Wren6991/Multimeter/pcb/case02.jpg

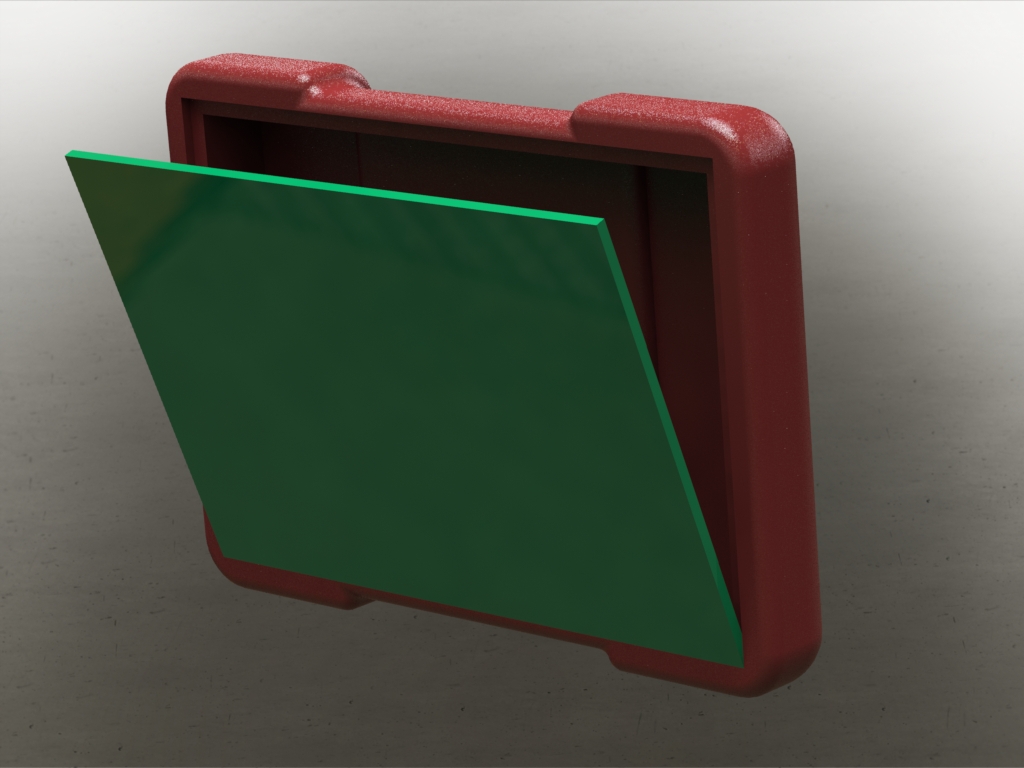
pcb/case02.jpg
