Wren6991/Multimeter/pcb/case01.JPG

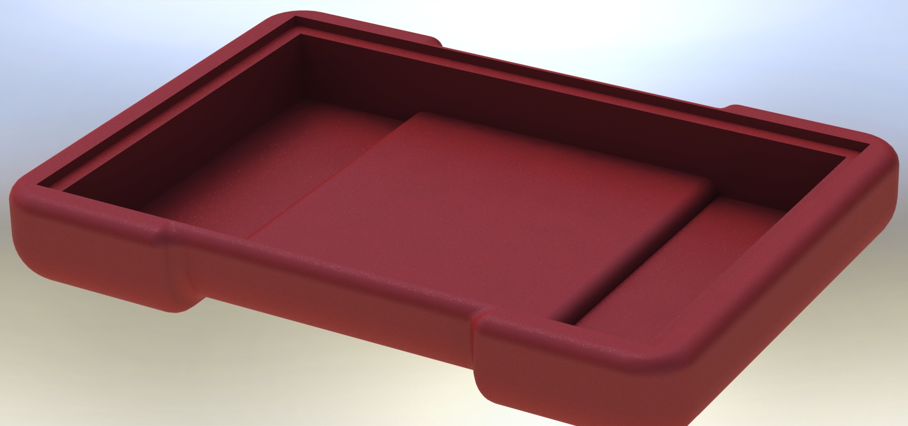
pcb/case01.JPG
