Wren6991/Multimeter/pcb/BOM.xlsx

Part no. | Description | Unit Cost (£ ex VAT) | Count | Total Cost
ATmega324PA | Microcontroller | 3.2 | 1
 | Lithium battery charger | 1 | 1
 | Infrared LED |  | 1
 | Yellow indicator LED |  | 1
 | Resistor 1206 0.22 Ohm |  | 1
 | Resistor 0805 47 Ohm |  | 2
 | Resistor 0805 500 Ohm |  | 3
 | Resistor 0805 1 kOhm |  | 9
 | Resistor 0805 5 kOhm |  | 3
 | Resistor 0805 10 kOhm |  | 2
 | Resistor 0805 20 kOhm |  | 1
 | Resistor 0805 100 kOhm |  | 1
 | Resistor 0805 1 MOhm |  | 2
 | Resistor Axial 0.25W 1MOhm |  | 1
 | MOSFET Logic N |  | 3
 | MOSFET Power N |  | 1
M25P16VP | SPI Flash 16Mbit |  | 1
MCP6502 | Opamp dual rail->rail low power |  | 1
 | 4mm Binding Post Black |  | 1
 | 4mm Binding Post Red |  | 2
 | Crystal 8MHz |  | 1
 | Capacitor 0805 0.1uF |  | 8
 | Capacitor 0603 22pF |  | 2
 | Diode Schottky 500mA |  | 4
 | Fuse 1206 2A fastblow |  | 1
 | Infrared Receiver 38kHz |  | 1
 | Switch Momentary Tactile |  | 4
