Wren6991/Multimeter/pcb/multimeter.brd

## EAGLE design pcb/multimeter.brd (2014-09-06)

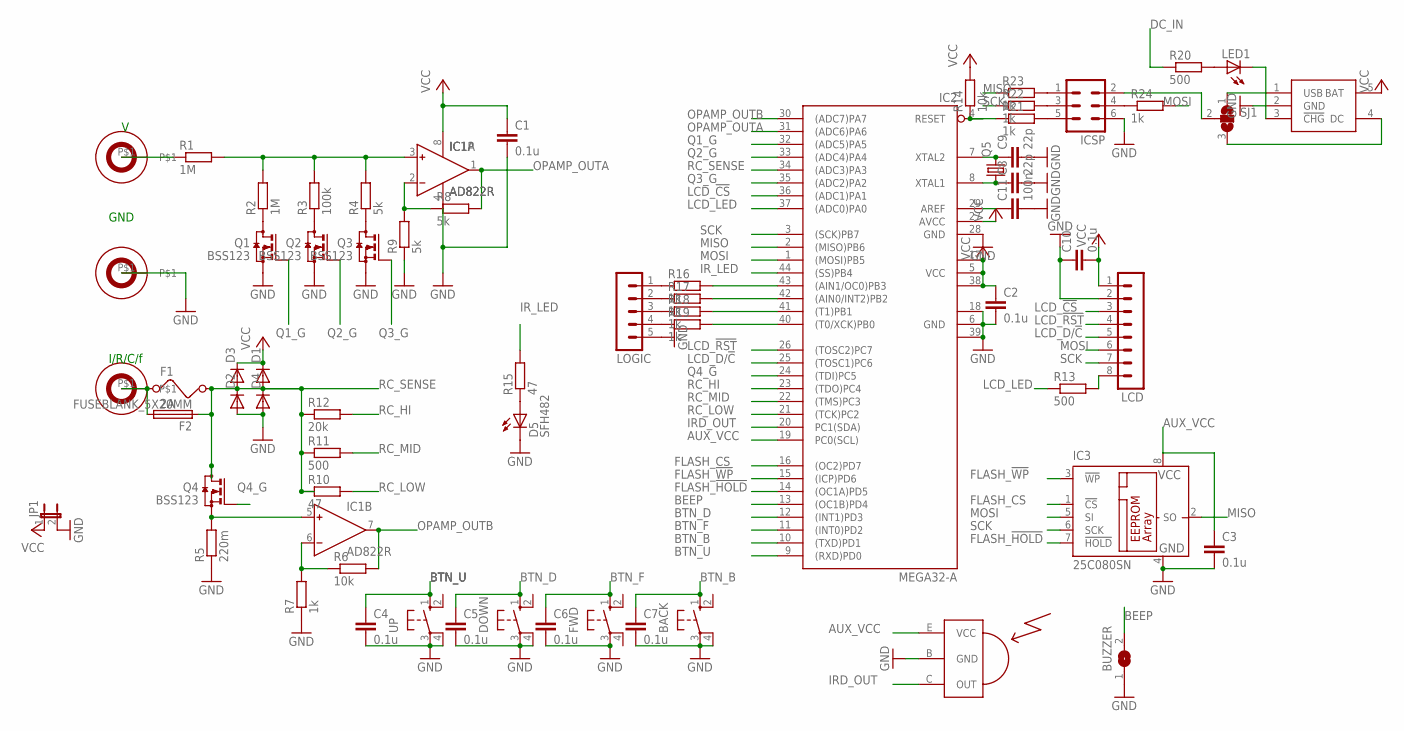
[picture p3: schematic multimeter.sch]

Parts:
BACK: 10-XX; B3F-10XX
BUZZER: SJW
C1, C2, C3, C4, C5, C6, C7, C10: 0.1u; C0805
C8, C9: 22p; C0603
C11: 100n; C0805
D1, D2, D3, D4: DIODE-SOD123; SOD123
D5: SFH482
DOWN: 10-XX; B3F-10XX
F1: 2A; R1206
F2: FUSEBLANK_5X20MM; FUSE_HOLDER_5X20MM
FWD: 10-XX; B3F-10XX
IC1: AD822R; SO8
IC2: MEGA32-A; TQFP44
IC3: 25C080SN; SO-08
ICSP: MA03-2
JP1: JP1E; JP1
LCD: MA08-1
LED1: LEDSML0805; SML0805
LOGIC: MA05-1
N$36: BINDINGPOST4MMPCB; BINDINGPOSTPCB
Q1, Q2, Q3, Q4: BSS123; SOT23
Q5: CRYSTALHC49UP; HC49UP
R1: 1M; 0207/12
R2: 1M; R0805
R3: 100k; R0805
R4, R8, R9: 5k; R0805
R5: 220m; R1206
R6, R14: 10k; R0805
R7, R16, R17, R18, R19, R21, R22, R23, R24: 1k; R0805
R10, R15: 47; R0805
R11, R13, R20: 500; R0805
R12: 20k; R0805
SJ1: SJ2W; SJ_2
U$1, U$2: BINDINGPOST4MMPCB; BINDINGPOSTPCB
U$3: IRDETECTOR; TO92-EBC
U$4: LITHIUMCHARGER; SOT23-5L
UP: 10-XX; B3F-10XX

Connections:
AUX_VCC: C3.1, IC2.19 (PC0(SCL)), IC3.8 (VCC), U$3.E (VCC)
BEEP: BUZZER.2, IC2.13 ((OC1B)PD4)
BTN_B: BACK.1 (S), C7.1, IC2.10 ((TXD)PD1)
BTN_D: C5.1, DOWN.1 (S), IC2.12 ((INT1)PD3)
BTN_F: C6.1, FWD.1 (S), IC2.11 ((INT0)PD2)
BTN_U: C4.1, IC2.9 ((RXD)PD0), UP.1 (S)
DC_IN: ICSP.2, R20.1, SJ1.2
FLASH_!HOLD: IC2.14 ((OC1A)PD5), IC3.7 (!HOLD)
FLASH_!WP: IC2.15 ((ICP)PD6), IC3.3 (!WP)
FLASH_CS: IC2.16 ((OC2)PD7), IC3.1 (!CS)
GND: BACK.3, BACK.4 (P1), BUZZER.1, C1.2, C2.2, C3.2, C4.2, C5.2, C6.2, C7.2, C8.2, C9.2, C10.1, C11.2, D2.A, D4.A, D5.K (C), DOWN.3, DOWN.4 (P1), FWD.3, IC1.4 (V-), IC2.6 (GND), IC2.18 (GND1), IC2.28 (GND), IC2.39 (GND2), IC3.4 (GND), ICSP.6, JP1.2, LCD.2, LOGIC.5, Q1.2 (S), Q2.2 (S), Q3.2 (S), R5.1, R7.1, R9.1, U$2.P$1, U$3.B (GND), U$4.2 (GND), UP.3, UP.4 (P1)
IRD_OUT: IC2.20 (PC1(SDA)), U$3.C (OUT)
IR_LED: IC2.44 ((SS)PB4), R15.2
LCD_!CS: IC2.36 ((ADC1)PA1), LCD.3
LCD_!RST: IC2.26 ((TOSC2)PC7), LCD.4
LCD_D/!C: IC2.25 ((TOSC1)PC6), LCD.5
LCD_LED: IC2.37 ((ADC0)PA0), R13.1
MISO: IC2.2 ((MISO)PB6), IC3.2 (SO), R23.1
MOSI: IC2.1 ((MOSI)PB5), IC3.5 (SI), LCD.6, R24.2
unnamed: D5.A, R15.1
unnamed: Q2.3 (D), R3.1
unnamed: LOGIC.1, R16.1
unnamed: IC1.3 (IN+), R1.2, R2.2, R3.2, R4.2
unnamed: IC1.5 (IN+), Q4.2 (S), R5.2
unnamed: LOGIC.2, R17.1
unnamed: IC1.6 (IN-), R6.1, R7.2
unnamed: LOGIC.3, R18.1
unnamed: IC1.2 (IN-), R8.1, R9.2
unnamed: LOGIC.4, R19.1
unnamed: IC2.43 ((AIN1/OC0)PB3), R16.2
unnamed: ICSP.4, R24.1
unnamed: IC2.42 ((AIN0/INT2)PB2), R17.2
unnamed: IC2.41 ((T1)PB1), R18.2
unnamed: IC2.40 ((T0/XCK)PB0), R19.2
unnamed: C9.1, IC2.7 (XTAL2), Q5.2
unnamed: R1.1, U$1.P$1
unnamed: C8.1, IC2.8 (XTAL1), Q5.1
unnamed: SJ1.3, U$4.4 (DC)
unnamed: IC2.4 (RESET), R14.1, R21.1
unnamed: SJ1.1, U$4.1 (USB)
unnamed: LED1.A, R20.2
unnamed: LED1.C, U$4.3 (!CHG)
unnamed: ICSP.5, R21.2
unnamed: ICSP.3, R22.2
unnamed: ICSP.1, R23.2
unnamed: C11.1, IC2.29 (AREF)
unnamed: LCD.8, R13.2
unnamed: F1.1, F2.2, N$36.P$1
unnamed: Q1.3 (D), R2.1
unnamed: Q3.3 (D), R4.1
OPAMP_OUTA: IC1.1 (OUT), IC2.31 ((ADC6)PA6), R8.2
OPAMP_OUTB: IC1.7 (OUT), IC2.30 ((ADC7)PA7), R6.2
Q1_G: IC2.32 ((ADC5)PA5), Q1.1 (G)
Q2_G: IC2.33 ((ADC4)PA4), Q2.1 (G)
Q3_G: IC2.35 ((ADC2)PA2), Q3.1 (G)
Q4_G: IC2.24 ((TDI)PC5), Q4.1 (G)
RC_HI: IC2.23 ((TDO)PC4), R12.2
RC_LOW: IC2.21 ((TCK)PC2), R10.2
RC_MID: IC2.22 ((TMS)PC3), R11.2
RC_SENSE: D1.A, D2.C, D3.A, D4.C, F1.2, F2.1, IC2.34 ((ADC3)PA3), Q4.3 (D), R10.1, R11.1, R12.1
SCK: IC2.3 ((SCK)PB7), IC3.6 (SCK), LCD.7, R22.1
VCC: C1.1, C2.1, C10.2, D1.C, D3.C, IC1.8 (V+), IC2.5 (VCC), IC2.17 (VCC1), IC2.27 (AVCC), IC2.38 (VCC2), JP1.1, LCD.1, R14.2, U$4.5 (BAT)

Notes on the sheet:
GND
I/R/C/f

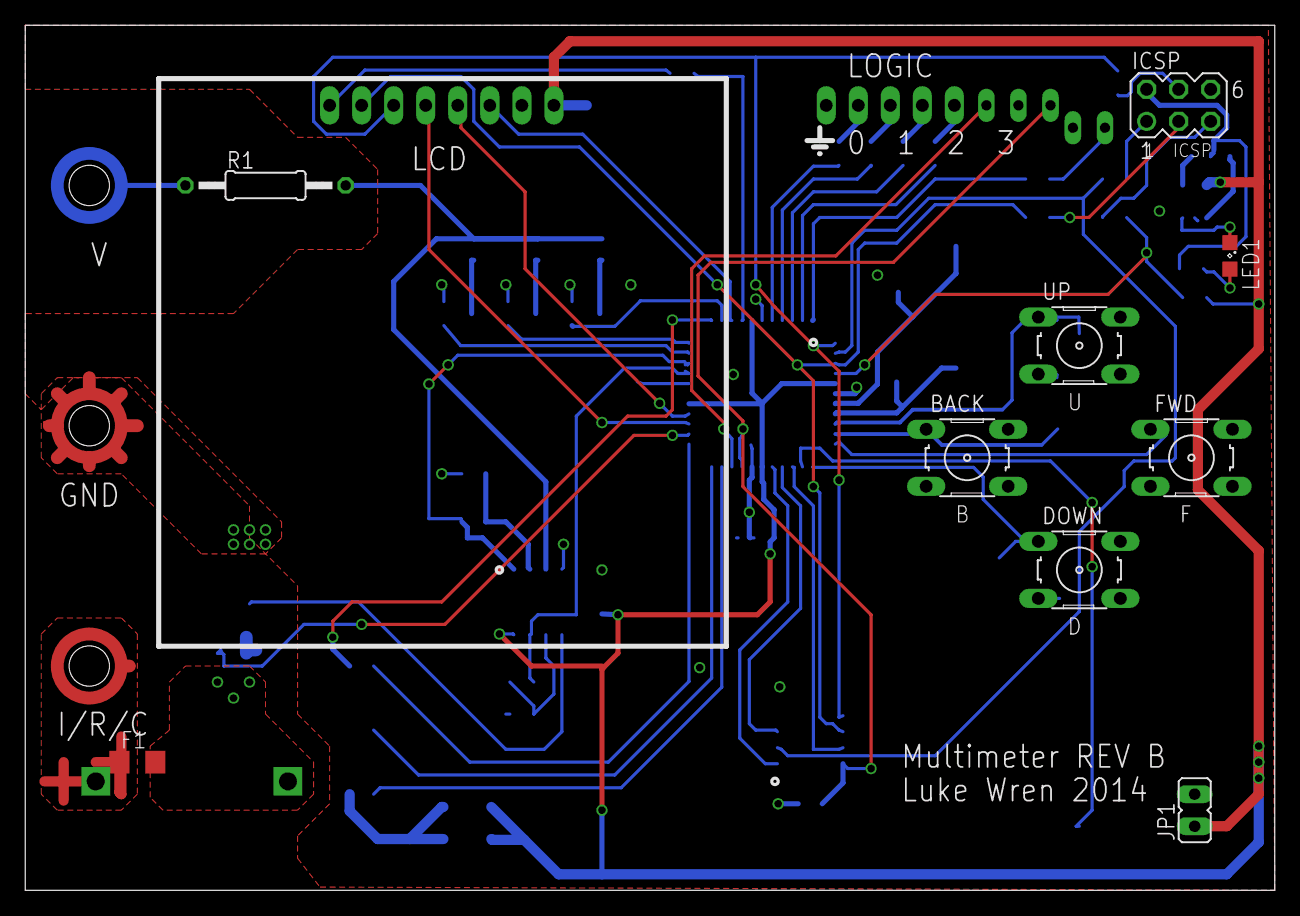
[picture p4: board multimeter.brd from above]

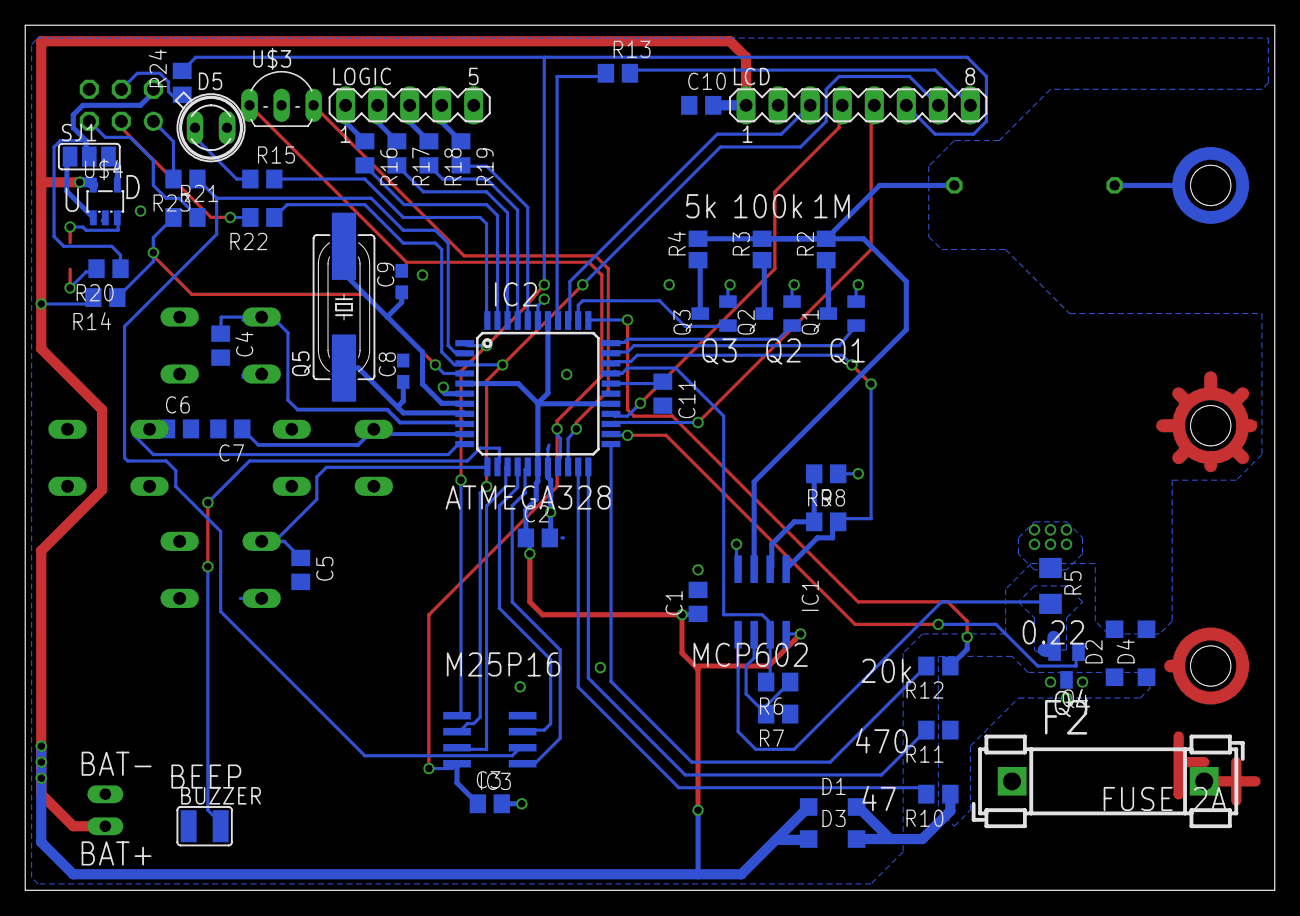
[picture p5: board multimeter.brd from below]

Board: 2 copper layers, 99.1 x 68.6 mm, 66 parts (55 on the bottom side), 62 nets.
