Wren6991/Multimeter/(commit log)

2014-09-06 Added simple SPI functions
2014-09-06 added SPI files
2014-09-06 added PCB files
    [BOM.xlsx, Resistance.xlsx, multimeter.brd, multimeter.sch, nonlinearity.xlsx, voltages.xlsx]
2014-09-06 added pcb files, connected charge LED to DC input instead of battery, connected Flash VCC to same net as IRD VCC
    [multimeter.brd, multimeter.sch]
2014-10-02 added assembly files for logic capture + scope
